koushiniku/bv_ft245_6502/schematics/sch.pdf

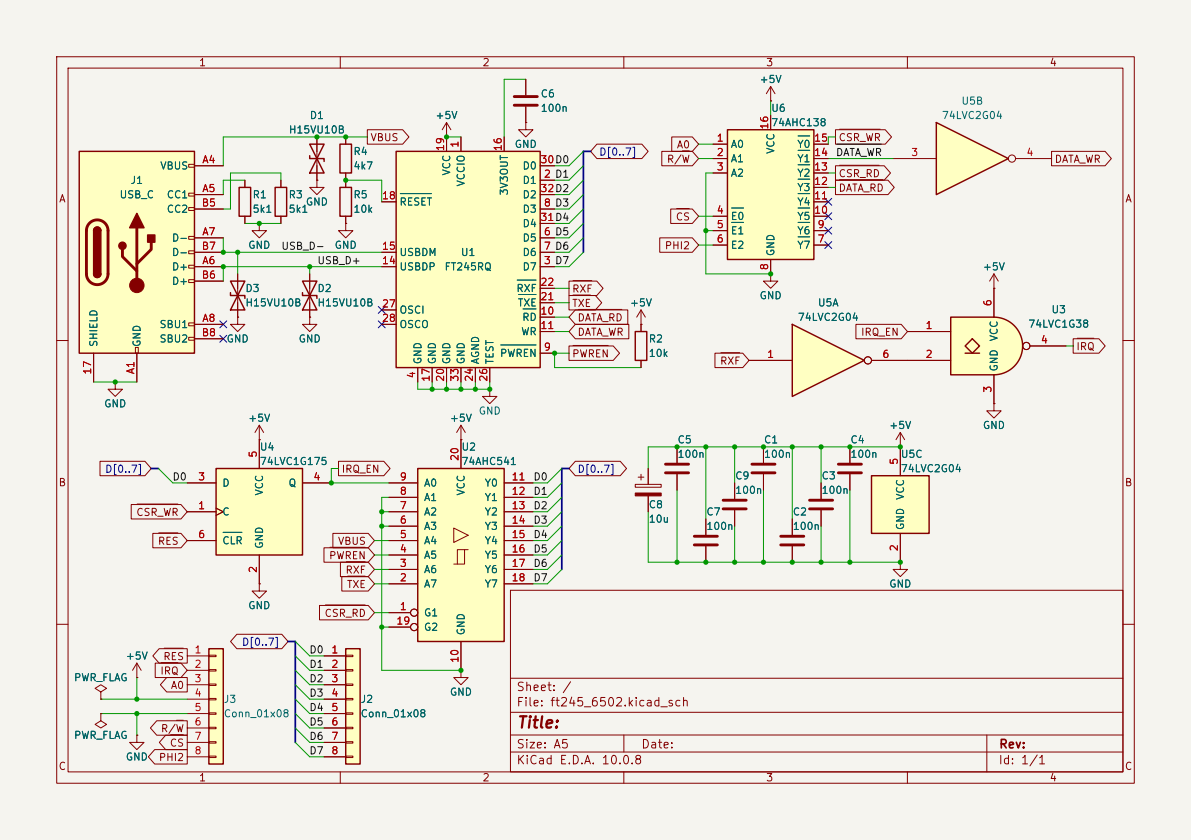
[picture p1: page 1]

4 D5 6 D6 7 D3 8 PWREN 9 RD 10 WR 11 USBDP 14 USBDM 15 3V3OUT 16 GND 17 RESET 18 VCC 19 GND 20

Size: A5 | Rev: | C Date:
KiCad E.D.A. 10.0.8 | Id: 1/1
