koushiniku/bv_ft245_6502/schematics/pcb.pdf

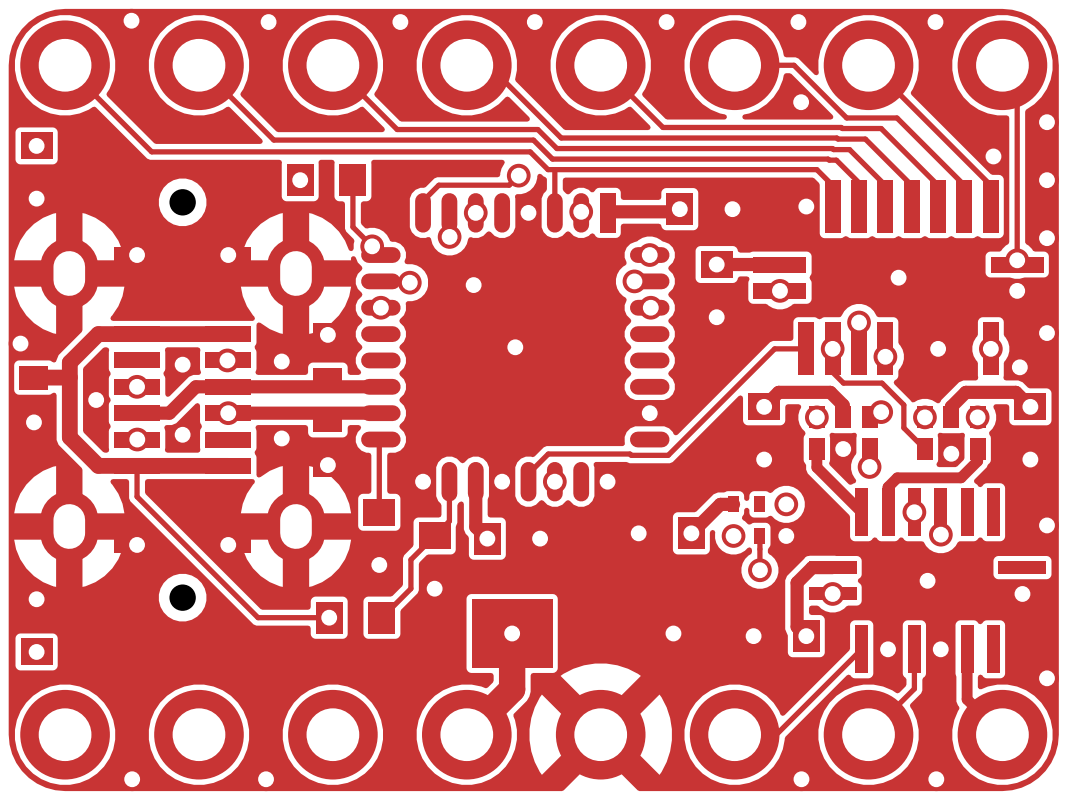
[picture p2: page 1]

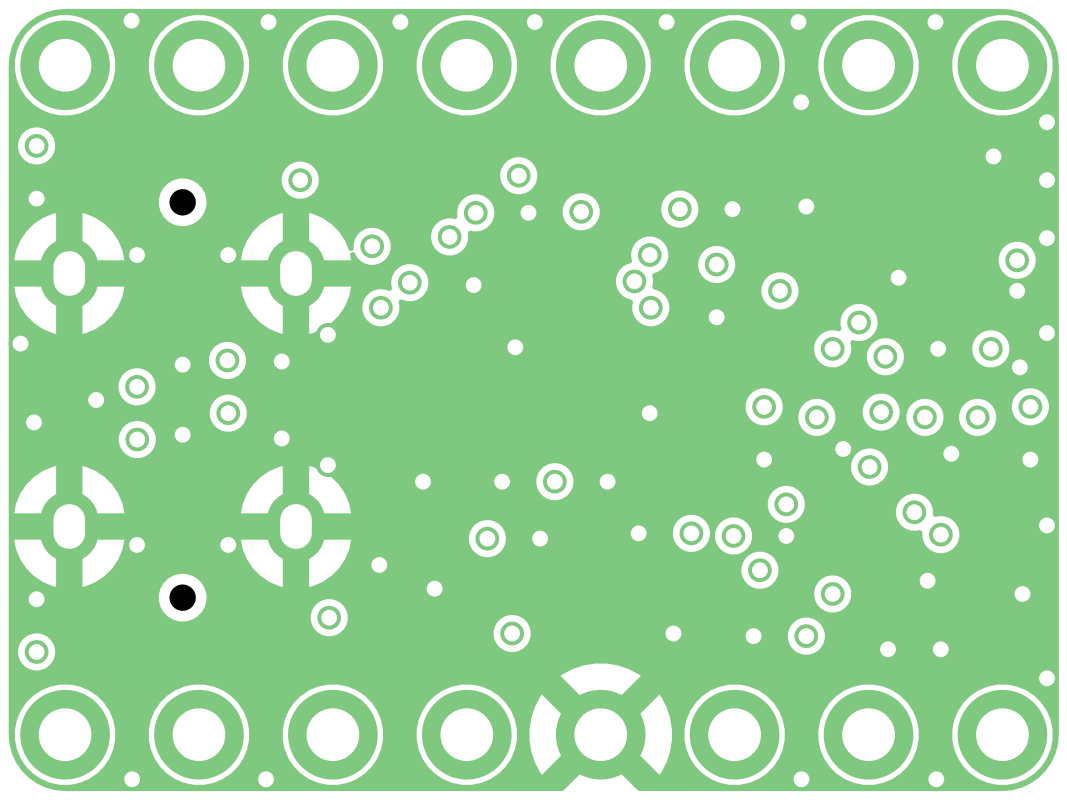
[picture p3: page 2]

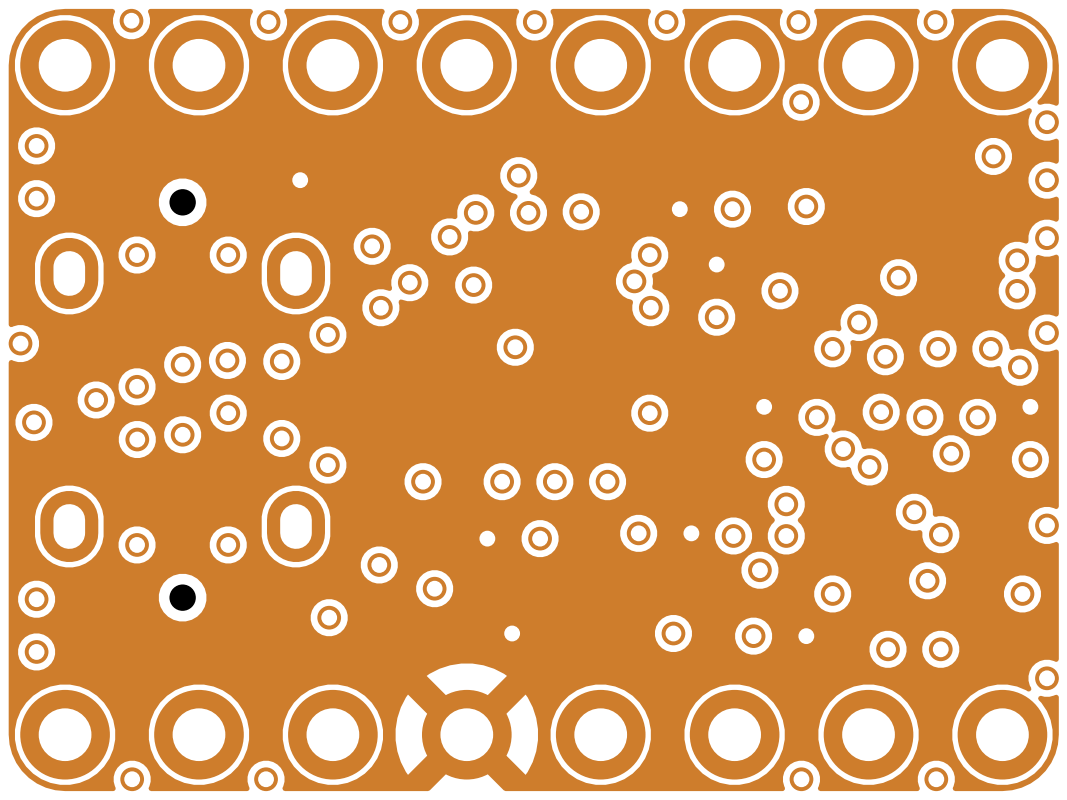
[picture p4: page 3]

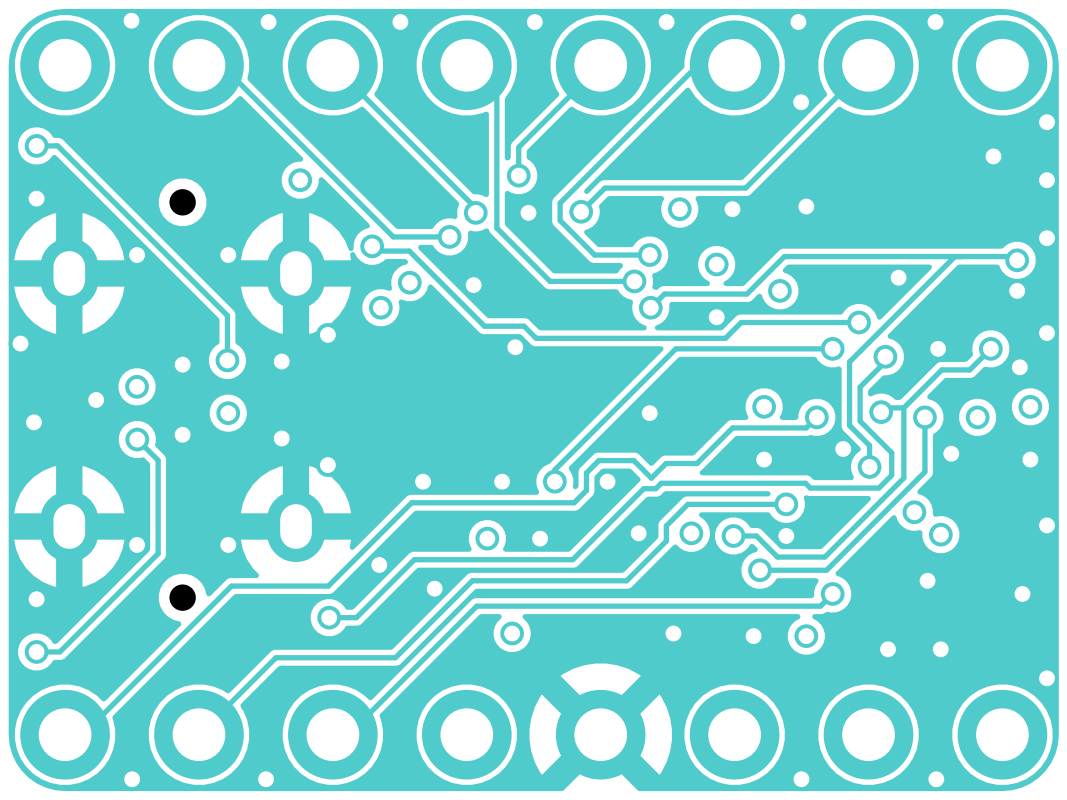
[picture p5: page 4]

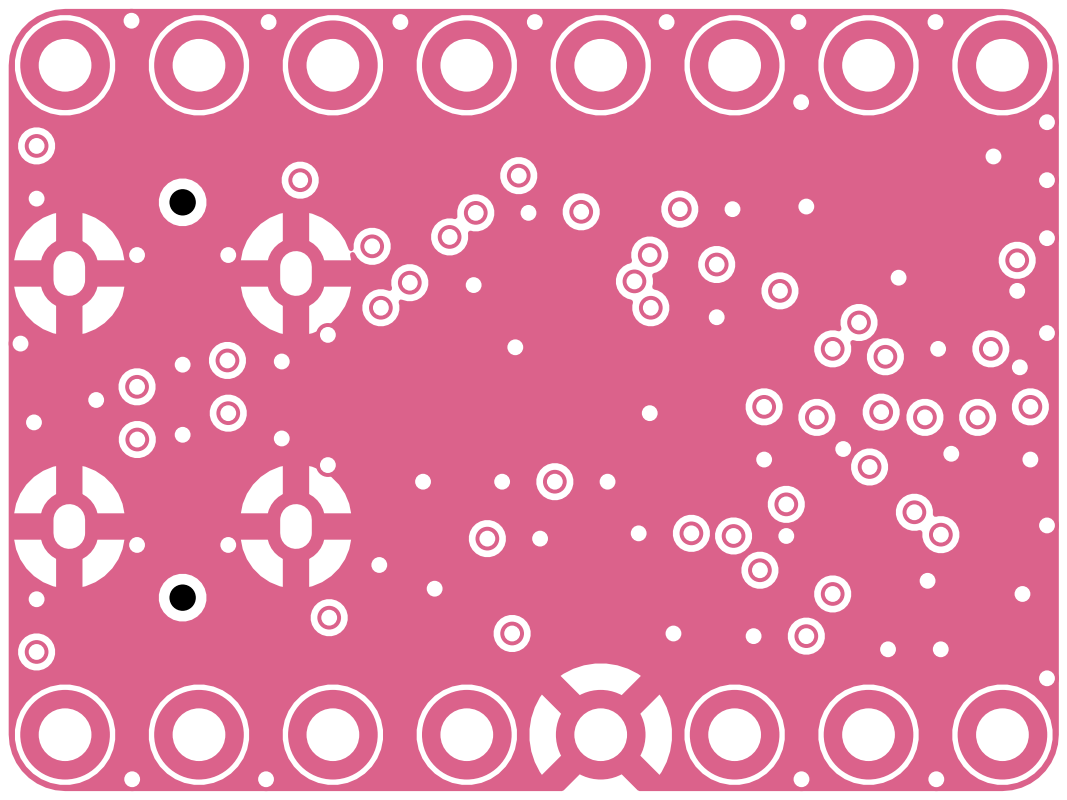
[picture p6: page 5]

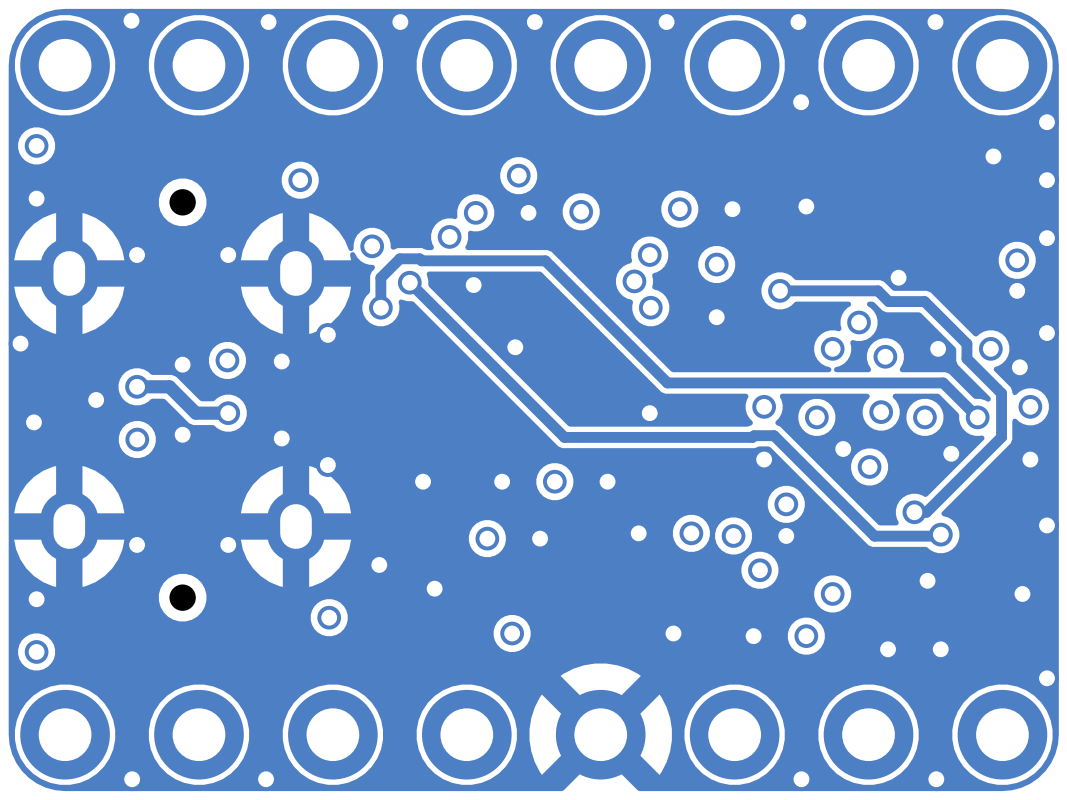
[picture p7: page 6]

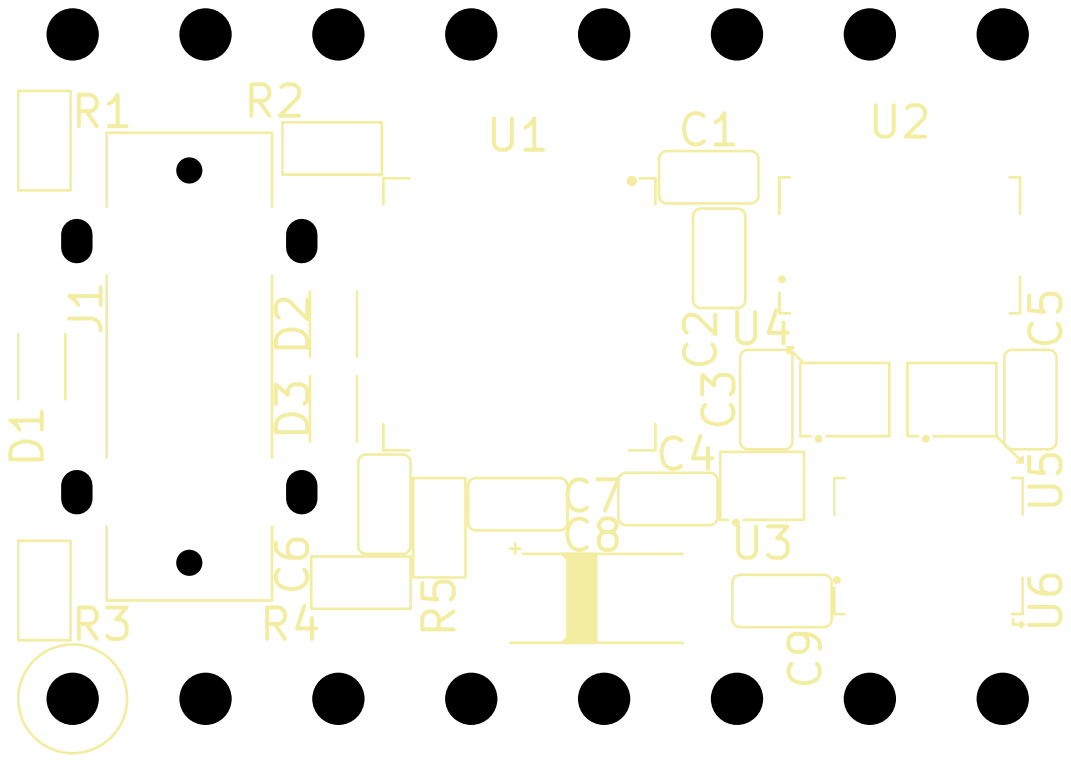
[picture p8: page 7]

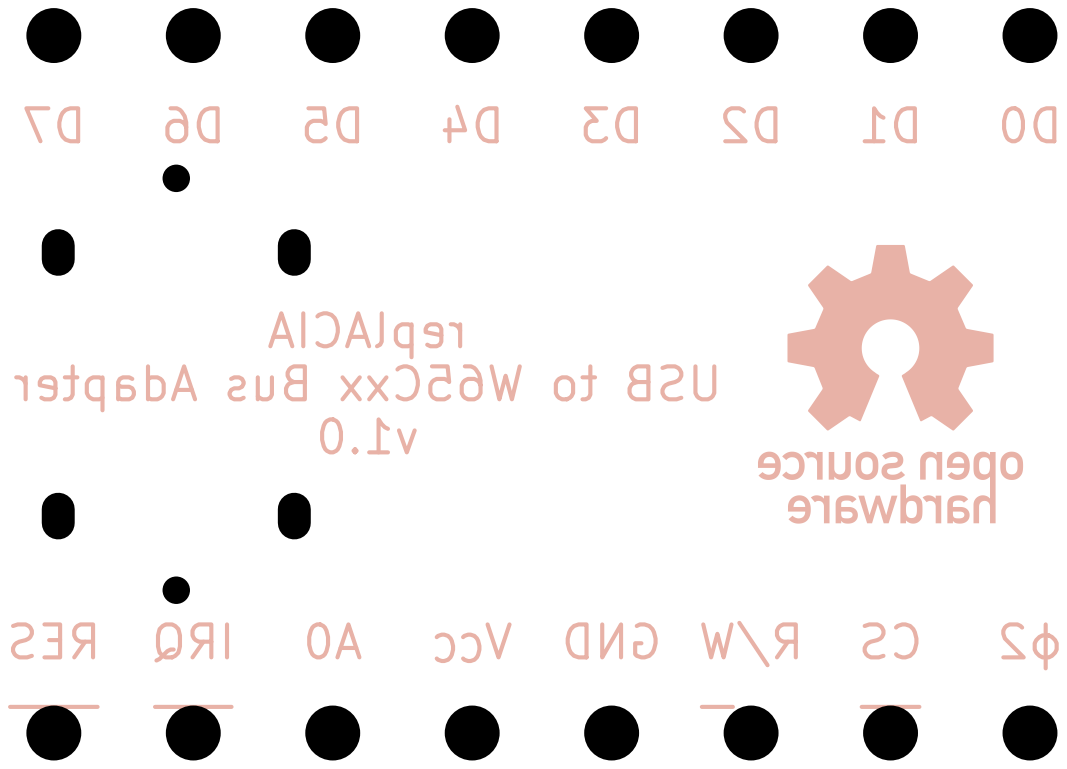
[picture p9: page 8]

Adapter Bus W65Cxx to USB

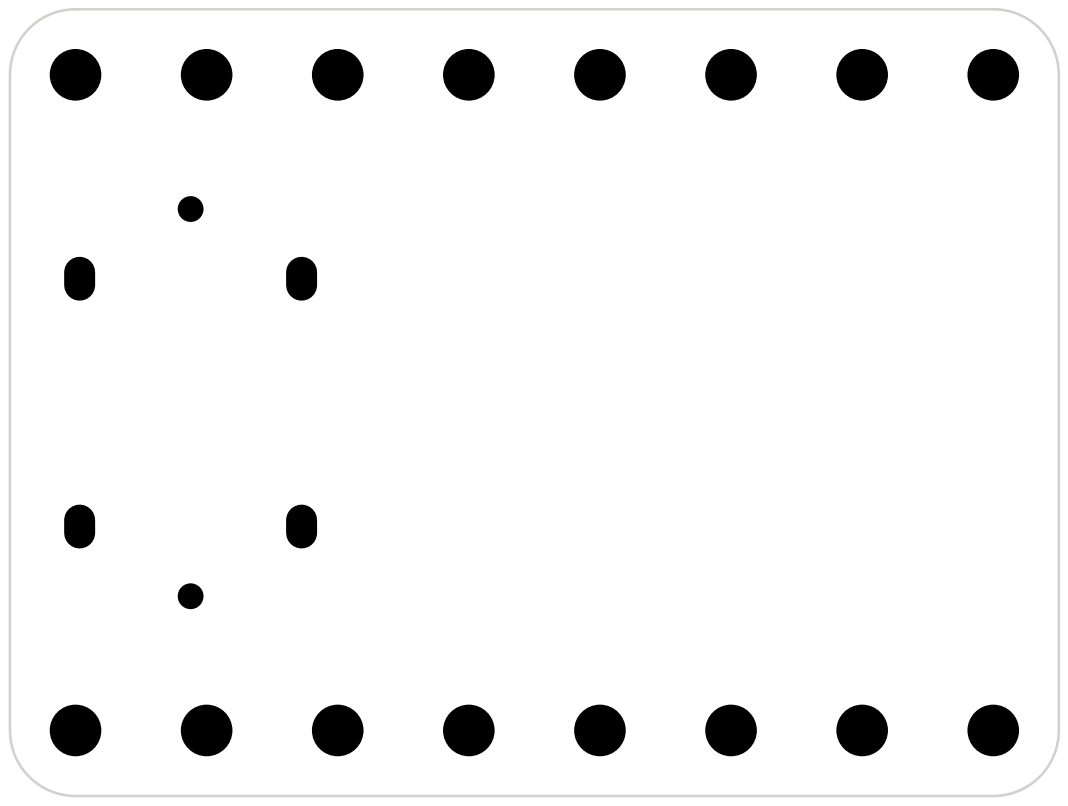
[picture p10: page 9]

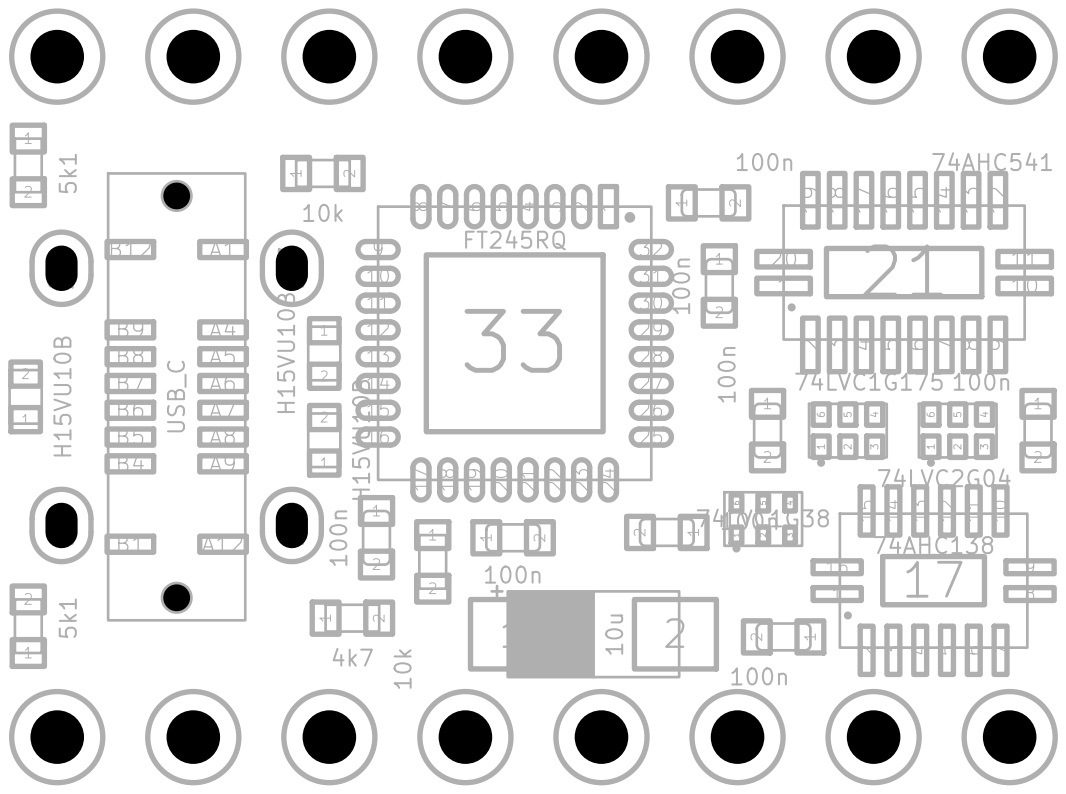
[picture p11: page 10]
