koushiniku/bv_ft245_6502/schematics/ft245_6502.kicad_pcb

## KiCad design schematics/ft245_6502.kicad_pcb (2026-11-13)

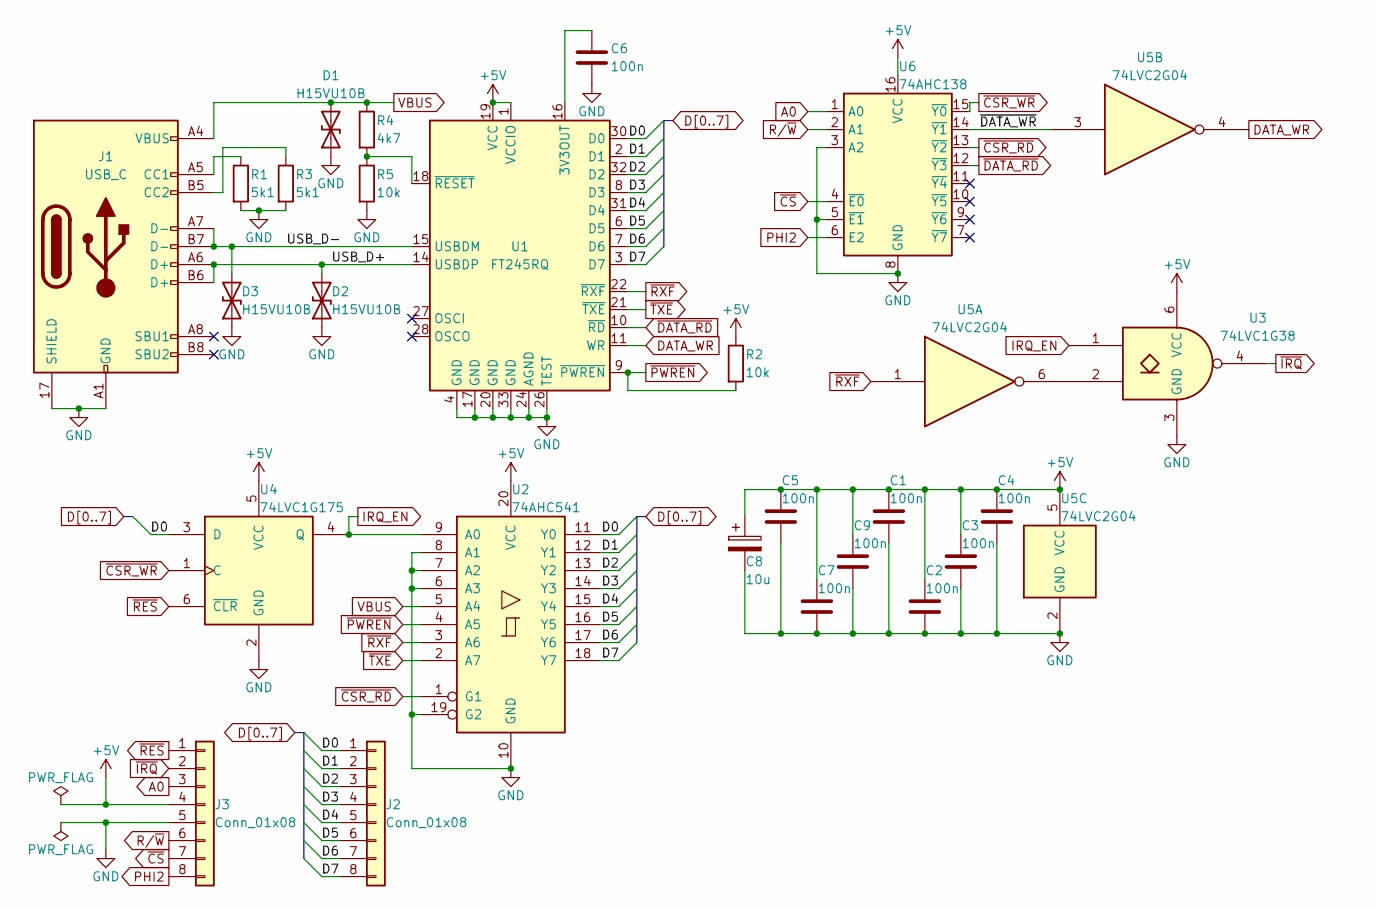
[picture p12: schematic ft245_6502.kicad_sch]

Parts:
C1, C2, C3, C4, C5, C6, C7, C9: 100n; CL05B104KO5NNNC; LCSC C1525
C8: 10u; TAJA106K016RNJ; LCSC C7171
D1, D2, D3: H15VU10B; LCSC C20615792
J1: USB_C; TYPE-C-16PLT6_8H-4PC-WT; LCSC C53059472
J2, J3: Conn_01x08; PinHeader_1x08_P2.54mm_Vertical
R1, R3: 5k1; 0402WGF5101TCE; LCSC C25905
R2, R5: 10k; 0402WGF1002TCE; LCSC C25744
R4: 4k7; 0402WGF4701TCE; LCSC C25900
U1: FT245RQ; FT245RQ-TRAY; LCSC C1550574
U2: 74AHC541; 74AHC541BQ-Q100X; LCSC C554414
U3: 74LVC1G38; EM74LVC1G38GM; LCSC C54929569
U4: 74LVC1G175; 74LVC1G175GM_115; LCSC C548286
U5: 74LVC2G04; 74LVC2G04GM_115; LCSC C426707
U6: 74AHC138; 74AHC138BQ_115; LCSC C554237

Connections:
+5V: C1.1, C2.1, C3.1, C4.1, C5.1, C7.1, C8.1, C9.1, J3.4, R2.1, U1.1 (VCCIO), U1.19 (VCC), U2.20 (VCC), U3.6 (VCC), U4.5 (VCC), U5.5 (VCC), U6.16 (VCC)
/USB_D+: D2.2 (A2), J1.A6 (D+), J1.B6 (D+), U1.14 (USBDP)
/USB_D-: D3.2 (A2), J1.A7 (D-), J1.B7 (D-), U1.15 (USBDM)
/~DATA_WR: U5.3, U6.14 (~Y1)
A0: J3.3, U6.1 (A0)
D0: J2.1, U1.30 (D0), U2.11 (Y0), U4.3 (D)
D1: J2.2, U1.2 (D1), U2.12 (Y1)
D2: J2.3, U1.32 (D2), U2.13 (Y2)
D3: J2.4, U1.8 (D3), U2.14 (Y3)
D4: J2.5, U1.31 (D4), U2.15 (Y4)
D5: J2.6, U1.6 (D5), U2.16 (Y5)
D6: J2.7, U1.7 (D6), U2.17 (Y6)
D7: J2.8, U1.3 (D7), U2.18 (Y7)
DATA_WR: U1.11 (WR), U5.4
GND: C1.2, C2.2, C3.2, C4.2, C5.2, C6.2, C7.2, C8.2, C9.2, D1.1 (A1), D2.1 (A1), D3.1 (A1), J1.17 (SHIELD), J1.18 (SHIELD), J1.19 (SHIELD), J1.20 (SHIELD), J1.A1 (GND), J1.A12 (GND), J1.B1 (GND), J1.B12 (GND), J3.5, R1.2, R3.2, R5.2, U1.4 (GND), U1.17 (GND), U1.20 (GND), U1.24 (AGND), U1.26 (TEST), U1.33 (GND), U2.6 (A3), U2.7 (A2), U2.8 (A1), U2.10 (GND), U2.19 (G2), U2.21 (GND), U3.3 (GND), U4.2 (GND), U5.2 (GND), U6.3 (A2), U6.5 (~E1), U6.8 (GND), U6.17 (GND)
IRQ_EN: U2.9 (A0), U3.1, U4.4 (Q)
unnamed: J1.A5 (CC1), R1.1
unnamed: J1.B5 (CC2), R3.1
unnamed: C6.1, U1.16 (3V3OUT)
unnamed: R4.2, R5.1, U1.18 (~RESET)
unnamed: U3.2, U5.6
PHI2: J3.8, U6.6 (E2)
R/~W: J3.6, U6.2 (A1)
VBUS: D1.2 (A2), J1.A4 (VBUS), J1.A9 (VBUS), J1.B4 (VBUS), J1.B9 (VBUS), R4.1, U2.5 (A4)
~CSR_RD: U2.1 (G1), U6.13 (~Y2)
~CSR_WR: U4.1 (C), U6.15 (~Y0)
~CS: J3.7, U6.4 (~E0)
~DATA_RD: U1.10 (~RD), U6.12 (~Y3)
~IRQ: J3.2, U3.4
~PWREN: R2.2, U1.9 (~PWREN), U2.4 (A5)
~RES: J3.1, U4.6 (~CLR)
~RXF: U1.22 (~RXF), U2.3 (A6), U5.1
~TXE: U1.21 (~TXE), U2.2 (A7)

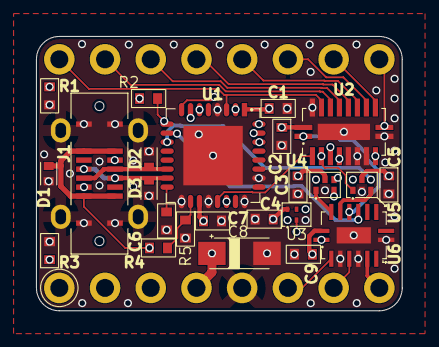
[picture p13: board ft245_6502.kicad_pcb from above]

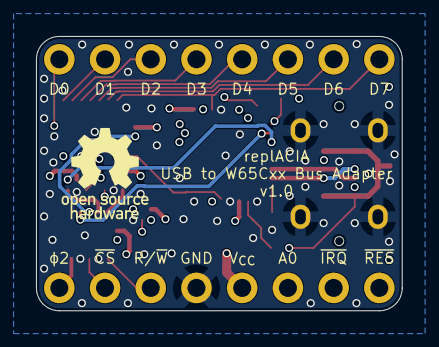
[picture p14: board ft245_6502.kicad_pcb from below]

Board: 6 copper layers, 20.3 x 15.2 mm, 26 parts (2 on the bottom side), 33 nets.
