koushiniku/bv_ft245_6502/(commit log)

2026-11-04 initial files
    [ft245_6502.kicad_pcb, ft245_6502.kicad_sch]
2026-11-04 added kicad library submodule
2026-11-10 design more or less complete
    [ft245_6502.kicad_pcb, ft245_6502.kicad_sch]
2026-11-10 added pdfs!
    [ft245_6502.kicad_pcb]
2026-11-10 fix footprint pads to match mfg recommendation
    [ft245_6502.kicad_pcb]
2026-11-11 fab ready?
    [ft245_6502.kicad_pcb, ft245_6502.kicad_sch]
2026-11-11 changed footprint and stackup for economic assembly
    [ft245_6502.kicad_pcb, ft245_6502.kicad_sch]
2026-11-13 back silkscreen text alignment
    [ft245_6502.kicad_pcb]
2026-11-13 OSHW license
    [ft245_6502.kicad_pcb]
